UterGrooll/scada-modbus-tcp-relay-timer/(commit log)

2026-05-09 Initial release of SCADA Modbus TCP relay timer
2026-05-18 add relay timer enable mode
2026-09-30 Align relay timer documentation with standalone firmware
